intisar-int/evm-atmega32-voting-machine/docs/figures/flowchart_voting_loop_detail.png

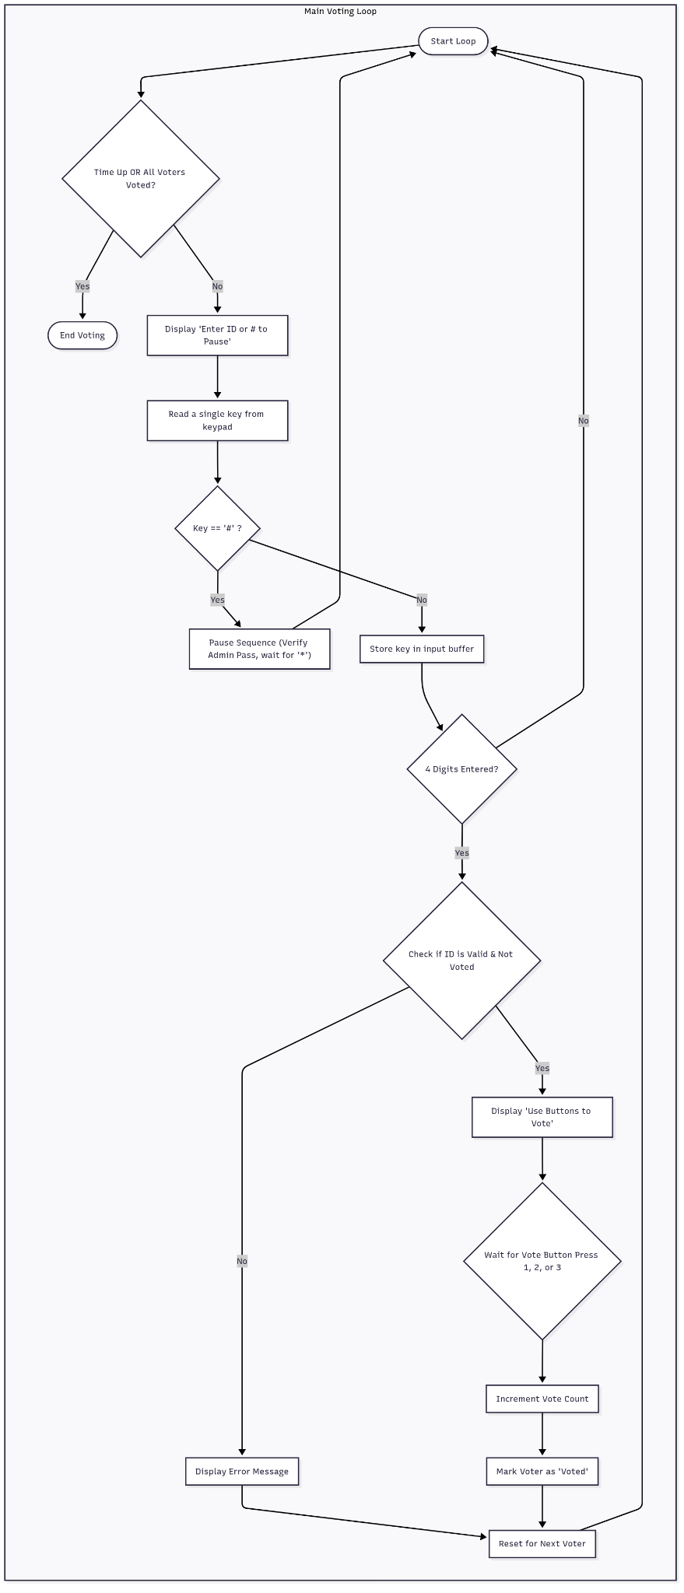
docs/figures/flowchart_voting_loop_detail.png
