intisar-int/evm-atmega32-voting-machine/(list of files, drawings)

Other design files:
simulation/proteus/EVM_Group02.pdsprj
