intisar-int/evm-atmega32-voting-machine/(notices)

Notices in the files:
README.md:
License: MIT
